dsdtech-official/can-adapters/docs/README.md

<!-- SPDX-FileCopyrightText: 2026 DongGuan DESHIDE TECHNOLOGY CO., LTD (DSD TECH) -->
<!-- SPDX-License-Identifier: CC-BY-SA-4.0 -->
# Shared documentation

Shared guides for adapters in this repository. Check each guide's model coverage.
Model-specific material lives in the model's own folder.

| File | Answers |
|---|---|
| [`software.md`](software.md) | Get diCAN for Windows or macOS; match your adapter and firmware to the available features |
| [`firmware-update-sh-c31a-sh-c31g.md`](firmware-update-sh-c31a-sh-c31g.md) | Illustrated Windows upgrade guide for SH-C31A / SH-C31G: BOOT switch, x64/ARM64 drivers, dfu-util and STM32CubeProgrammer pictures |
| `identify-firmware.md` | Which firmware is on my adapter, and how do I change it? |
| `termination.md` | When must the 120 Ω terminator be switched off? *(the #1 support question)* |
| `leds.md` | What the three lights mean, and why the green ones are dark |
| `other-firmware.md` | **ElmueSoft CANable 2.5** — optional third-party firmware for the SH-C31A and SH-C31G, and which of its two forms you want |
| `elmue-candlelight-2.5.md` | What changes on the bench with the gs_usb form of it |
| `elmue-slcan-2.5.md` | What changes on the bench with the serial-port form of it |

More is being written — measured bit rate and sample point tables, per-OS setup guides and
troubleshooting.
