dsdtech-official/can-adapters/SH-C31G/README.md

<!-- SPDX-FileCopyrightText: 2026 DongGuan DESHIDE TECHNOLOGY CO., LTD (DSD TECH) -->
<!-- SPDX-License-Identifier: CC-BY-SA-4.0 -->
# SH-C31G

**Galvanically isolated** USB to **CAN FD** adapter. The isolated sibling of the
[SH-C31A](../SH-C31A/) — same microcontroller, same firmware, with the CAN side cut loose
from the USB side. Part of the **CANable** family: lineage and attribution in
[`THIRD-PARTY-NOTICES.md`](../THIRD-PARTY-NOTICES.md).

> **Buy:** <https://www.deshide.com/product-details_SH-C31G.html> ·
> **Non-isolated version:** [SH-C31A](../SH-C31A/)

| | |
|---|---|
| MCU | **STM32G431** — 170 MHz Cortex-M4F, FDCAN. Both the **C8T6** (64 KB flash) and the **CBT6** (128 KB) are fitted in production; the firmware is the same either way |
| Transceiver | **TJA1051T/3** (NXP) |
| **Isolation** | ✅ **Digital isolator + isolated DC-DC.** Signal *and* power are isolated — the parts, and which one we actually fit, are in [`hardware/`](hardware/) |
| **CAN FD** | ✅ **Working out of the box, at data rates up to 5 Mbit/s** — same firmware and same interface as the SH-C31A, see [`firmware/`](firmware/) |
| Classic CAN | CAN 2.0A and 2.0B |
| Clock | No external crystal — the MCU runs from its internal oscillator |
| USB | USB 2.0 Full Speed, **Type-B receptacle** (cable not captive) |
| CAN | **4-pin 5.08 mm screw terminal** — CAN_L / CAN_H / GND / +5 V |
| Board | 53.5 × 36.0 mm |

> ⚠️ **One limit is your software, not this adapter.** Over SocketCAN every standard
> nominal rate works. `python-can`'s `gs_usb` backend can only open 500 kbit/s and
> 1 Mbit/s — a restriction inside that library, not a property of the board.
> [`firmware/`](firmware/) has the measurements.

## The isolated side powers itself

**You do not need an external supply.** The on-board DC-DC converter makes the isolated
5 V from USB, and the transceiver runs from it. Pin 4 of the terminal carries that isolated
5 V, so it can also feed a small load on the bus side — it is an output, not an input.

## Software

Use **[diCAN](../docs/software.md)** on Windows or macOS to view, send and record CAN
traffic with this adapter. CAN FD availability depends on the firmware installed;
the guide shows how to check it.

## Start here

1. **[Manual](manual/)** — wiring, LEDs, first connection
2. **Check the 120 Ω terminator.** Switch it **off** when the bus already has two, which a
   vehicle bus does → [`docs/termination.md`](../docs/termination.md)
3. **Check your firmware.** We recommend the shared **v1.5** build for SH-C31G owners;
   see the [firmware downloads](firmware/) and the illustrated
   [Windows firmware upgrade guide](../docs/firmware-update-sh-c31a-sh-c31g.md).
4. **The green LEDs stay dark until software opens the channel.** That is normal →
   [`docs/leds.md`](../docs/leds.md)
5. **[Examples](examples/)** — read the bus, send a frame, send an FD frame

## In this folder

| | |
|---|---|
| [`manual/`](manual/) | User manual |
| [`datasheet/`](datasheet/) | Electrical and mechanical specifications |
| [`hardware/`](hardware/) | Schematic and board files |
| [`firmware/`](firmware/) | What it runs, what that firmware can do, and how to change it |
| [`examples/`](examples/) | Working code |

Firmware images are attached to [Releases](../../../releases), not stored in this folder.

## Licence

Hardware design files: **CERN-OHL-S-2.0** · Documentation: **CC-BY-SA-4.0** ·
Example code: **BSD-3-Clause** · Firmware images: **MIT**. See [LICENSES/](../LICENSES/).

**No warranty.** Provided AS IS.
