dsdtech-official/can-adapters/SH-C30A/firmware/README.md

<!-- SPDX-FileCopyrightText: 2026 DongGuan DESHIDE TECHNOLOGY CO., LTD (DSD TECH) -->
<!-- SPDX-License-Identifier: CC-BY-SA-4.0 -->
# SH-C30A — Firmware

## What this board ships with

**candlelight.** The adapter presents itself as a raw USB device: the kernel `gs_usb`
driver on Linux, WinUSB on Windows.

**The SH-C30A has no CAN FD and cannot gain it by reflashing** — the STM32F072 has a
classic bxCAN peripheral, not FDCAN. It runs CAN 2.0A and 2.0B at up to 1 Mbit/s.

### Your adapter may be running an earlier build

**Units produced from September 2026 ship with v2.1**, the image on
[Releases](#download). Anything made before that carries the stock CANable build, and so
does older stock still moving through distribution. **Those units keep working and you can
stay on them** -- but `v2.1` does fix two behaviours worth having:

- **closing the channel purges the transmit queue**, so frames left over from one session no
  longer go out after the next open
- **both LEDs work**

**v2.1 runs the microcontroller from the 24 MHz crystal fitted on the board.** Every
SH-C30A has that crystal.

**To check which one you have**, look at the name the adapter reports over USB:

| | |
|---|---|
| Windows | Device Manager, under *Universal Serial Bus devices* |
| Linux | `lsusb` |

v2.1 reports itself as **`SH-C30x`**, made by **`DSD TECH`**. Anything else is an earlier
build. To move to v2.1, take it from **[Download](#download)** below and flash it. A USB
cable is all you need.

## Which firmware do I have?

Two personalities exist for this class of adapter and they look completely different to the
host. Ten seconds to tell them apart →
[`docs/identify-firmware.md`](../../docs/identify-firmware.md)

| | **candlelight** | **slcan** |
|---|---|---|
| Appears as | a raw USB device | a serial port |
| Windows | *Universal Serial Bus devices*, WinUSB | `COM<n>` under *Ports* |
| Linux | kernel `gs_usb` → a **SocketCAN** interface | `/dev/ttyACM<n>` |

## Download

**[SH-C30A firmware v2.1](https://github.com/dsdtech-official/can-adapters/releases/tag/SH-C30A/fw-v2.1)** — the current build, and what units produced from September 2026
ship with.

| File | |
|---|---|
| [`SH-C30x_v2.1.dfu`](https://github.com/dsdtech-official/can-adapters/releases/download/SH-C30A/fw-v2.1/SH-C30x_v2.1.dfu) | **Start here.** DfuSe format, for `dfu-util` or ST tools |
| [`SH-C30x_v2.1.bin`](https://github.com/dsdtech-official/can-adapters/releases/download/SH-C30A/fw-v2.1/SH-C30x_v2.1.bin) | Raw image, flashed at `0x08000000` |
| [`SH-C30x_v2.1.hex`](https://github.com/dsdtech-official/can-adapters/releases/download/SH-C30A/fw-v2.1/SH-C30x_v2.1.hex) | Intel HEX |
| [`SHA256SUMS.txt`](https://github.com/dsdtech-official/can-adapters/releases/download/SH-C30A/fw-v2.1/SHA256SUMS.txt) | Checksums for the three above |
| [`THIRD-PARTY-NOTICES.md`](https://github.com/dsdtech-official/can-adapters/releases/download/SH-C30A/fw-v2.1/THIRD-PARTY-NOTICES.md) | The licence notice. **Carry it with the images if you mirror them** |

One build serves **SH-C30A, SH-C30G and SH-C30L**.

Check what you downloaded before flashing it:

```bash
sha256sum -c SHA256SUMS.txt
```

Images are not kept in this folder. Binaries cannot be removed from git history
afterwards, and a release ties an image to a version you can quote in a support request.

## Flashing

Both personalities are flashed over USB DFU, to the STM32 system bootloader
(`0483:DF11`). A USB cable is all you need.

> ⚠️ **Reflashing is not required for normal use.** An adapter on an earlier build keeps
> working. Reflash if you want the current build, or if you specifically need the other
> personality.

## Licence and attribution

The firmware images we publish are built from **candleLight_fw** by **Hubert Denkmair**,
released under the **MIT** licence.

> Copyright (c) 2016 Hubert Denkmair — [`LICENSES/MIT.txt`](../../LICENSES/MIT.txt)

MIT requires the copyright and permission notice to be included **in binary distributions
too**, so [`THIRD-PARTY-NOTICES.md`](../../THIRD-PARTY-NOTICES.md) ships with every firmware
release. It also records two components inside candleLight_fw that carry their own terms —
the **STM32 HAL** (BSD-style) and the **STM32 USB library**
(**ST Ultimate Liberty License SLA0044**, not an OSI-approved licence).

**If you mirror our firmware images anywhere, carry that file with them.**
