dsdtech-official/can-adapters/docs/other-firmware.md

<!-- SPDX-FileCopyrightText: 2026 DongGuan DESHIDE TECHNOLOGY CO., LTD (DSD TECH) -->
<!-- SPDX-License-Identifier: CC-BY-SA-4.0 -->
# Other firmware — ElmueSoft CANable 2.5

The **SH-C31A** and **SH-C31G** ship with our own gs_usb build. They will also run
**ElmueSoft's CANable 2.5 firmware**, which is a separate project by a different author,
and we publish it here so you can choose.

> ### With thanks to Elmue
>
> **The DSD TECH team is very grateful to Elmue for this work.** CANable 2.5 is his own
> project, written and maintained by him, and he made it work across a range of boards from
> different manufacturers — including ours. The `Multiboard` builds on this page exist
> because he took the trouble to support hardware that has no crystal fitted, which is what
> our SH-C31A and SH-C31G are.
>
> His work is his own. Nothing on this page should be read as him endorsing us or our
> products.

> ## 🔴 What you download here is a snapshot, not the latest
>
> **These files are one specific build, commit
> [`eb1c7e35`](https://github.com/Elmue/CANable-2.5-firmware-Slcan-and-Candlelight/commit/eb1c7e3589b6135469dd0745c3a81911b88513c6)
> of 2026-09-15, mirrored here on 2026-09-16.** Elmue improves this firmware on his own
> schedule, and when he does, **what is on this page is out of date until we catch up.**
>
> **The current version is always on his own pages, never here:**
> <https://netcult.ch/elmue/CANable%20Firmware%20Update> ·
> <https://github.com/Elmue/CANable-2.5-firmware-Slcan-and-Candlelight>
>
> We mirror a pinned build for two reasons only: so the checksums below have something to
> check against, and so the file stays reachable. **If you want the newest, go to his
> repository.**

## First: which firmwares exist at all

There are four, and only four:

| | Host interface | Whose it is |
|---|---|---|
| **legacy candleLight** (`gs_usb`) | raw USB | the original open-source project. **Our own build is in this class** |
| **legacy slcan** | serial port | the original open-source project |
| **Candlelight 2.5** | raw USB | ElmueSoft — a rework of the first one. **On this page** |
| **Slcan 2.5** | serial port | ElmueSoft — a rework of the second one. **On this page** |

The division that matters is **raw USB versus serial port**, because it decides which
software can talk to the adapter at all. The `2.5` pair are Elmue's rewrites: the same two
host interfaces, but with added features, error reporting the legacy builds never had, and
different bit-timing defaults.

## Which of the two do I want?

Both are built from the same source at the same version. They differ in **how the adapter
talks to your computer**, and that decides which software can use it.

| | **Candlelight 2.5** | **Slcan 2.5** |
|---|---|---|
| Host interface | Raw USB (`gs_usb` / WinUSB) | **CDC virtual serial port** |
| Windows driver | **None to install — WinUSB binds by itself** | **None to install — it appears as a COM port** |
| Linux | SocketCAN via the kernel `gs_usb` driver | SocketCAN via `slcand`, or any serial tool |
| CAN FD | ✅ | ✅ |
| Closest to what we ship | ✅ same class of interface | ❌ different class entirely |
| Details | [`elmue-candlelight-2.5.md`](elmue-candlelight-2.5.md) | [`elmue-slcan-2.5.md`](elmue-slcan-2.5.md) |

> ℹ️ **Neither of these needs a driver installed by hand on Windows.** Candlelight 2.5
> carries the descriptors that make Windows bind WinUSB on its own; Slcan 2.5 shows up as a
> COM port. **The manual-driver step you may have read about belongs to the *legacy*
> candleLight firmware, not to these.**
>
> ⛔ **Do not run Zadig against either of them.** It installs the driver under a randomly
> generated device GUID, and software looking for the standard one will then not find the
> adapter at all. Elmue's own firmware updater can repair a registry Zadig has done this to.

**If you are happy with the firmware the adapter came with, you do not need either of
these.** Our own build is what we test, what we support, and what every measurement on the
model pages was taken on.

**Reasons people do want one of them:**

- **Slcan 2.5** puts the adapter on a plain COM port. If your software wants a serial
  port, or you would rather not deal with WinUSB at all, this is the one.
- **Candlelight 2.5** adds features our build does not have — `GET_STATE`, bus load
  reporting, filter and pin control, flash read/write — through Elmue's own extensions to
  the protocol.

**The author's own case for updating**, which we think is fair to pass on: 2.5 adds features
the legacy firmware does not have, and — the one we would single out — **it reports error
states that the legacy firmware simply did not surface at all**. If you have been chasing a
bus fault you could not see, that on its own may be worth the update.

## Three things to know before you flash

Each of these looks like a fault and is not. **Full detail is on the two pages linked in the
table above** — this is the short form.

| | |
|---|---|
| **Candlelight 2.5 reports the same USB `VID:PID` as our own build** | Both are `1D50:606F`. Any script or udev rule keyed on that alone matches both. Tell them apart by the **product string** — `Candlelight 2.5 - …` here, `SH-C31x` on ours. ⛔ Not by `bcdDevice`: his carries a build version and moves every release |
| **The CAN clock is 160 MHz; ours is 170 MHz** | Software that asks the device for its clock is fine. Software that assumes a fixed clock programs the wrong timings and **goes bus-off immediately** — it does not degrade into "a slightly different rate" |
| **On Slcan 2.5, `S7` is 800 kbit/s** | `python-can`'s slcan interface assumes 750 k, so it will run the bus at 800 k while believing it set 750 k. There is no standard value for `S7`; the two conventions both exist |

## Software: the author's own application

**If you flash this firmware, [HUD ECU Hacker](https://netcult.ch/elmue/HUD%20ECU%20Hacker/)
is the application it was written alongside — we recommend it.** Elmue wrote CANable 2.5
while adding CANable support to that program, and his documentation says it supports the new
firmware's features in full.

It can also **install this firmware for you**: it carries a built-in CANable firmware
updater, and using that is what he recommends over flashing by hand.

| | |
|---|---|
| What it is | ECU diagnostics and tuning, with a built-in CAN bus debugger, logger and terminal |
| Protocols | CAN Raw, ISO 15765, **J1939** (8 500 parameters), **NMEA 2000** (3 000 parameters), K-Line (ISO 9141, ISO 14230, KW1281, Honda) |
| Platform | **Windows only** — 7, 8, 10 and 11. Not Linux |
| Price | **Charityware** — he asks for a donation to a non-profit of your choice, not to himself |
| Source | Closed |
| Where | <https://netcult.ch/elmue/HUD%20ECU%20Hacker/> |

**We link rather than bundle it, and the capabilities listed above are his description
rather than our measurements.** Questions about it go to him, the same as for the firmware.

> **On Linux you need none of this.** The Candlelight build comes up as a SocketCAN
> interface through the kernel `gs_usb` driver, and the Slcan build through `slcand` — then
> `can-utils`, `python-can` or anything else that speaks SocketCAN.
>
> ⚠️ **What that route does not give you are Elmue's 2.5 extensions.** `gs_usb` speaks the
> original protocol, so `GET_STATE`, bus load, filters, pin control and flash access are not
> reachable through SocketCAN — those need his own host code. **Ordinary CAN and CAN FD
> traffic work normally.**

## Download

Both files are attached to a single release here, and both are **byte-for-byte the files
Elmue publishes**, taken from a pinned commit:

**[ElmueSoft CANable 2.5](https://github.com/dsdtech-official/can-adapters/releases/tag/SH-C31A/elmue-2.5)**

| File | For | SHA-256 |
|---|---|---|
| `STM32G431-Candlelight2.5-Multiboard.dfu` | gs_usb / WinUSB | `79d438f5…870480` |
| `STM32G431-Slcan2.5-Multiboard.dfu` | CDC serial port | `8d958470…65555a` |
| `SHA256SUMS.txt` | checksums for both | — |
| `THIRD-PARTY-NOTICES.md` | **the MIT notice. Carry it if you mirror these** | — |

> ℹ️ **What these checksums are for — and what they are not for.** A `.dfu` file already
> carries its own CRC32, and both `dfu-util` and the firmware updater in HUD ECU Hacker
> refuse to flash a file whose CRC does not match. **A half-finished download cannot reach
> the board**, so you do not need SHA-256 to protect yourself from that.
>
> They are here for the other reason: **this is a mirror of someone else's binary, and the
> hashes are how you confirm our copy is byte-for-byte the file Elmue published** rather
> than something we changed. Check them against his repository if you want to verify that
> for yourself instead of taking our word for it.

```bash
sha256sum -c SHA256SUMS.txt
```

### Where these came from, exactly

| | |
|---|---|
| Upstream | <https://github.com/Elmue/CANable-2.5-firmware-Slcan-and-Candlelight> |
| Pinned commit | [`eb1c7e35`](https://github.com/Elmue/CANable-2.5-firmware-Slcan-and-Candlelight/commit/eb1c7e3589b6135469dd0745c3a81911b88513c6) · 2026-09-15 |
| Author's page | <https://netcult.ch/elmue/CANable%20Firmware%20Update> |

> ℹ️ **We renamed the two files.** Upstream calls them
> `STM32G431 - Candlelight2.5 - Multiboard.dfu` and `STM32G431 - Slcan2.5 - Multiboard.dfu`,
> with spaces. GitHub replaces spaces in release assets with periods, which would break
> `sha256sum -c`, so ours use hyphens instead. **The contents are untouched** — the
> checksums above are of the upstream files exactly as published.

**We pin a commit rather than linking a branch,** because a branch moves and what we
publish is the build we actually put on a board. We verified that the files in the release
above are identical to that commit — same SHA-256, same byte count.

> ⚠️ **Upstream ships 18 different `.dfu` files.** They are for different boards and
> different clock configurations. **Take exactly the two named above** — the `Multiboard`
> ones. Flashing a variant built for a 25 MHz crystal onto a board that has none will not
> work, and the failure is not obvious.

> ⚠️ **Newer versions may exist upstream, and sooner or later one will.** We pin a build
> because that is the one we put on a board — see the snapshot notice at the top of this
> page. **His repository has the current one before we do.**

### Updated from a previous snapshot?

Until 2026-09-17 this page carried commit `e862f6a6` of 2026-08-27. **What changed between
the two is his to describe, not ours** — we did not make those changes, and guessing at them
would be worse than not saying. **His release notes and his own pages are the authority:**

* <https://netcult.ch/elmue/CANable%20Firmware%20Update>
* <https://github.com/Elmue/CANable-2.5-firmware-Slcan-and-Candlelight>

One practical note, because it concerns the file **we** handed out rather than anything we
can tell you about his work: if you are staying on the copy we published before 2026-09-17
and you drive the adapter directly over `gs_usb`, **keep your `echo_id` inside `1`–`255`.**
We do not see that behaviour on the current file, and the Linux kernel's `gs_usb` driver is
not affected either way.

> ⚠️ **Do not identify this firmware by `bcdDevice`.** It carries his build version, so it
> moves every time he releases. **Match on the product string** — `Candlelight 2.5 - …` or
> `Slcan 2.5 - …`.

## Flashing

These files are flashed through the STM32 system bootloader (`0483:DF11`), but **how you
enter DFU depends on the firmware currently on your adapter**. On SH-C31A or SH-C31G
running our v1.5, first unlock BOOT0 as described in the
[SH-C31A flashing steps](../SH-C31A/firmware/#flashing). On an as-shipped SH-C31B,
BOOT0 is disabled, so the switch alone will not enter DFU. Check its firmware and the
author's update instructions before starting. Do not erase the running firmware until
you have confirmed the adapter is in ROM DFU mode.

### Going back

Our own build is on the model's firmware page
([SH-C31A](../SH-C31A/firmware/README.md#download) ·
[SH-C31G](../SH-C31G/firmware/README.md)). The bootloader lives in ROM, but a disabled
BOOT0 pin means the switch alone cannot reach it. Follow your model's unlock steps
before changing firmware, and verify the new firmware's BOOT0 behavior before flashing.

## What we support, and what we do not

**We did not write this firmware, we do not maintain it, and we cannot rebuild it** — what
we publish is the author's own precompiled file, not something we compiled ourselves.

| | |
|---|---|
| **Hardware faults** | ✅ Ours. Warranty is unaffected by which firmware you run |
| **Getting back to our firmware** | ✅ Ours — ask us |
| **Bugs in CANable 2.5** | ⛔ Report upstream: <https://github.com/Elmue/CANable-2.5-firmware-Slcan-and-Candlelight/issues> |
| **Feature requests for CANable 2.5** | ⛔ Upstream. It is his project |

**Please do not send Elmue support requests about our hardware, and please do not send us
feature requests about his firmware.** Each of us can only fix our own half.

## Licence

The firmware source carries **the MIT licence**:

```
The MIT License
Copyright (c) 2025 ElmueSoft / Nakanishi Kiyomaro / Normadotcom
https://netcult.ch/elmue/CANable Firmware Update
```

MIT permits redistribution in source or binary form **provided that notice travels with
it**, which is why [`THIRD-PARTY-NOTICES.md`](../THIRD-PARTY-NOTICES.md) is attached to the
release. **If you mirror these images anywhere, carry that file with them.**

> Note that the copyright is held by **three** parties, not one. The sample applications in
> the same upstream repository are under a **different** licence (BSD-3-Clause) — if you use
> those as well, read their own `License.txt`.
