dsdtech-official/can-adapters/SH-C30G/examples/linux-socketcan.md

<!-- SPDX-FileCopyrightText: 2026 DongGuan DESHIDE TECHNOLOGY CO., LTD (DSD TECH) -->
<!-- SPDX-License-Identifier: CC-BY-SA-4.0 -->
# SH-C30G on Linux — SocketCAN

Nothing to install: the kernel `gs_usb` driver claims the adapter and presents it as a
standard CAN network interface.

> ## Before anything else: **which firmware is on this adapter?**
>
> SH-C30G has shipped with **two different firmwares**, both of which are in the field
> today, and **you cannot tell them apart by looking at the board**. They behave
> differently in one way that will cost you a debugging session. Identify first.

## Check the kernel picked it up

```bash
ip link show | grep can
```

A `can0` interface means the kernel driver has it. If you get a `/dev/ttyACM<n>` instead,
the adapter is running a serial-port firmware rather than a CAN one →
[`docs/identify-firmware.md`](../../docs/identify-firmware.md)

## Identify the firmware

```bash
cat /sys/class/net/can0/device/../bcdDevice \
    /sys/class/net/can0/device/../product \
    /sys/class/net/can0/device/../manufacturer
```

That prints, in order, the device release number, the product string and the vendor
string — the three fields that name the firmware. To list every candleLight-family
adapter on the machine instead:

```bash
for d in /sys/bus/usb/devices/*; do
  [ -e "$d/idVendor" ] || continue
  [ "$(cat "$d/idVendor")" = "1d50" ] && [ "$(cat "$d/idProduct")" = "606f" ] || continue
  printf '%-10s bcdDevice=%-6s product=%-32s manufacturer=%s\n' \
    "${d##*/}" "$(cat "$d/bcdDevice")" "$(cat "$d/product")" "$(cat "$d/manufacturer")"
done
```

| `bcdDevice` | `product` | This is |
|---|---|---|
| `0100` | `SH-C30x` *(or `sh-C30x`)* | the firmware a **new** adapter ships with |
| `0000` | `candleLight USB to CAN adapter` | an adapter made **before September 2026** |
| `0000` · `0200` | `canable2 gs_usb` · `SH-C31x` | ⚠️ **not this product** — that is an SH-C31A |

📖 **The full table, what differs between the two, and the rules for reading any of
it are in [`README.md`](README.md)** — one place, so there is only one to keep right.

> 🔴 **The one difference that bites on Linux.** On the older firmware,
> `ip link set can0 down` with frames still queued does **not** discard them; they go out
> after you bring the interface back up, into whatever bus you are attached to by then.
> **Drain before you take the interface down.** The current firmware purges both queues
> on close. ⛔ **Do not carry a workaround for one over to the other.**

## Bring the bus up

```bash
sudo ip link set can0 up type can bitrate 500000
```

⚠️ **Every node on a bus must use the same bit rate**, and the bus must be terminated at
both ends and nowhere else → [`docs/termination.md`](../../docs/termination.md)

### 🔴 Hardware limit: **10 kbit/s cannot transmit on this board**

This is a property of the **board**, not of either firmware — it is there on both firmwares
alike, and reflashing will not change it.

The transceiver's dominant-state timeout is **400–500 µs**, and five consecutive dominant
bits at 10 kbit/s take **500 µs**. A frame containing five consecutive dominant bits never
gets out. Reproduced across three firmwares, two boards and two independent
implementations.

> **On provenance:** those runs were on the [SH-C30A](../../SH-C30A/examples/) — same
> image, equivalent transceiver from a different vendor. **We have not measured it on the
> SH-C30G itself.** The table below is what we would assume here; confirm it on your own
> bench if 10–20 kbit/s matters to you.

> ⚠️ **SocketCAN will let you do it anyway.** `ip link set can0 up type can bitrate 10000`
> succeeds, the interface comes up, and then frames silently fail to leave. There is no
> error to tell you why. (On Windows, python-can happens to refuse 10 kbit/s for an
> unrelated reason, which hides the problem rather than reporting it.)

| Rate | |
|---|---|
| 5 kbit/s | ⛔ do not use — worse than 10 k by the same mechanism |
| **10 kbit/s** | 🔴 **opens but cannot transmit** |
| 20 kbit/s | ⚠️ works, but only **17 %** margin against the transceiver's timeout |
| **100 kbit/s – 1 Mbit/s** | ✅ the usable range |

## Watch traffic

```bash
candump can0
```

## Send a frame

```bash
cansend can0 123#DEADBEEF
```

> ⚠️ **`cansend` returning does not mean the frame reached the bus.** With no other node
> to acknowledge, the controller retransmits indefinitely, the transmit error counter
> climbs to 128 and the controller goes error-passive — measured on this hardware, TEC
> stops at 128 and it never reaches bus-off. Nothing is printed. To see it:
>
> ```bash
> ip -details -statistics link show can0 | grep -A2 -E 'state|bus_error'
> candump can0,#FFFFFFFF          # error frames as well as data frames
> ```

## Listen without transmitting

`listen-only` asks the CAN controller for silent mode: it receives, and it does not drive
the bus — no frames of its own, and no acknowledgements.

```bash
sudo ip link set can0 down
sudo ip link set can0 up type can bitrate 500000 listen-only on
```

✅ **Measured on both SH-C30G firmwares** (2026-09-15): with the adapter in `listen-only`,
a witness node on the same bus recorded **zero** frames from it. Both firmwares honour
it.

> ⚠️ **Still prove it on a bench before you trust it on a vehicle** — and here is a
> concrete reason, not a formality: **the original firmware of our other model, the
> SH-C31A, reports `listen-only` and does not honour it.** It transmits and acknowledges
> anyway. If your fleet mixes adapters, verify each one on a bus you own.
>
> (SH-C30G is not affected. This is exactly why the identify step at the top matters.)

## Take the bus down

```bash
sudo ip link set can0 down
```

🔴 **On the older firmware, drain first** — see the note under [Identify the firmware](#identify-the-firmware).

---

`candump` and `cansend` come from **can-utils** (`sudo apt install can-utils`).
