dsdtech-official/can-adapters/docs/compliance/README.md

<!-- SPDX-FileCopyrightText: 2026 DongGuan DESHIDE TECHNOLOGY CO., LTD (DSD TECH) -->
<!-- SPDX-License-Identifier: CC-BY-SA-4.0 -->
# Compliance documents

Original laboratory attestations for DSD TECH USB-to-CAN adapters are provided
below. Each PDF lists the same five models; the files are shared rather than
copied into each model folder.

## Documents

| Document | Registration number | Issue date | Original PDF |
|---|---|---|---|
| CE (EMC) attestation of conformity | AGC09162260901E2 | 2026-09-28 | [View / download PDF](ce-emc-AGC09162260901E2.pdf) |
| RoHS attestation of conformity | AGC09162260901-C001 | 2026-09-15 | [View / download PDF](rohs-AGC09162260901-C001.pdf) |

Applicant / manufacturer: **DongGuan DESHIDE TECHNOLOGY CO.,LTD**.
Brand: **DSD TECH**.

## Models listed in both documents

| Model | CE (EMC) PDF | RoHS PDF |
|---|---|---|
| [SH-C30A](../../SH-C30A/) | Listed | Listed |
| [SH-C30L](../../SH-C30L/) | Listed | Listed |
| [SH-C31A](../../SH-C31A/) | Listed | Listed |
| [SH-C31B](../../SH-C31B/) | Listed | Listed |
| SH-C32A | Listed | Listed |

SH-C32A is listed in these attestations but does not yet have a model folder
in this repository. This index does not define its product specifications.
Models not listed in these PDFs are outside the stated scope of these documents.
The documents concern the specified DSD TECH products; building a board from
open hardware files does not transfer their coverage to that board.

## Scope and supporting reports

- The CE (EMC) attestation concerns Directive 2014/30/EU and lists
  EN 55032:2015+A11:2020+A1:2020 and EN 55035:2017+A11:2020.
  It references test report **AGC09162260901EE01**.
- The RoHS attestation concerns Directive 2011/65/EU and amendment
  (EU) 2015/863. It lists IEC 62321 test standards and references test report
  **AGC09162260901-001**.

These PDFs are laboratory attestations, not the full test reports or a
manufacturer-signed EU Declaration of Conformity. The referenced full reports
are not included here. The PDFs state that they should be used in conjunction
with the full reports and do not imply assessment of the whole production.

## Original files and terms

The PDFs are distributed complete and unchanged. Their own printed conditions
remain applicable, including restrictions on partial reproduction; do not
extract signatures, stamps or selected pages as separate proof documents.

These laboratory PDFs are **not relicensed under this repository's CC BY-SA,
hardware or software licences**. The adjacent `.license` files identify the
[original document terms](../../LICENSES/LicenseRef-Original-Compliance-Terms.txt),
without asserting a copyright owner that the PDFs do not identify. That
identifier records the existing terms; it does not grant a new open licence.
The explanatory text in this index follows the repository's documentation
licence. See [Licensing](../../LICENSE.md).

[All CAN adapters](../../README.md)
