dsdtech-official/can-adapters/SH-C31B/datasheet/README.md

<!-- SPDX-FileCopyrightText: 2026 DongGuan DESHIDE TECHNOLOGY CO., LTD (DSD TECH) -->
<!-- SPDX-License-Identifier: CC-BY-SA-4.0 -->
# SH-C31B — Datasheet

Electrical and mechanical specifications for the SH-C31B.

**The board is an [SH-C31A](../../SH-C31A/)** — the electrical and mechanical figures are
the same, and only the firmware fitted at the factory differs.

_Being migrated here from the product page. Until it lands:_ <https://www.deshide.com>
