dsdtech-official/can-adapters/SH-C31B/manual/README.md

<!-- SPDX-FileCopyrightText: 2026 DongGuan DESHIDE TECHNOLOGY CO., LTD (DSD TECH) -->
<!-- SPDX-License-Identifier: CC-BY-SA-4.0 -->
# SH-C31B — Manual

The user manual for the SH-C31B.

**Wiring, LEDs and termination are the same as the [SH-C31A](../../SH-C31A/).** What differs
is the first connection: this adapter appears as a **serial port**, not as a gs_usb device →
[`docs/elmue-slcan-2.5.md`](../../docs/elmue-slcan-2.5.md)

_Being migrated here from the product page. Until it lands:_ <https://www.deshide.com>
