dsdtech-official/can-adapters/SH-C30A/manual/README.md

<!-- SPDX-FileCopyrightText: 2026 DongGuan DESHIDE TECHNOLOGY CO., LTD (DSD TECH) -->
<!-- SPDX-License-Identifier: CC-BY-SA-4.0 -->
# SH-C30A — Manual

The user manual for the SH-C30A.

_Being migrated here from the product page. Until it lands:_ <https://www.deshide.com>
