dsdtech-official/can-adapters/SH-C30L/hardware/SH-C30L-V1.0.pdf

1

2

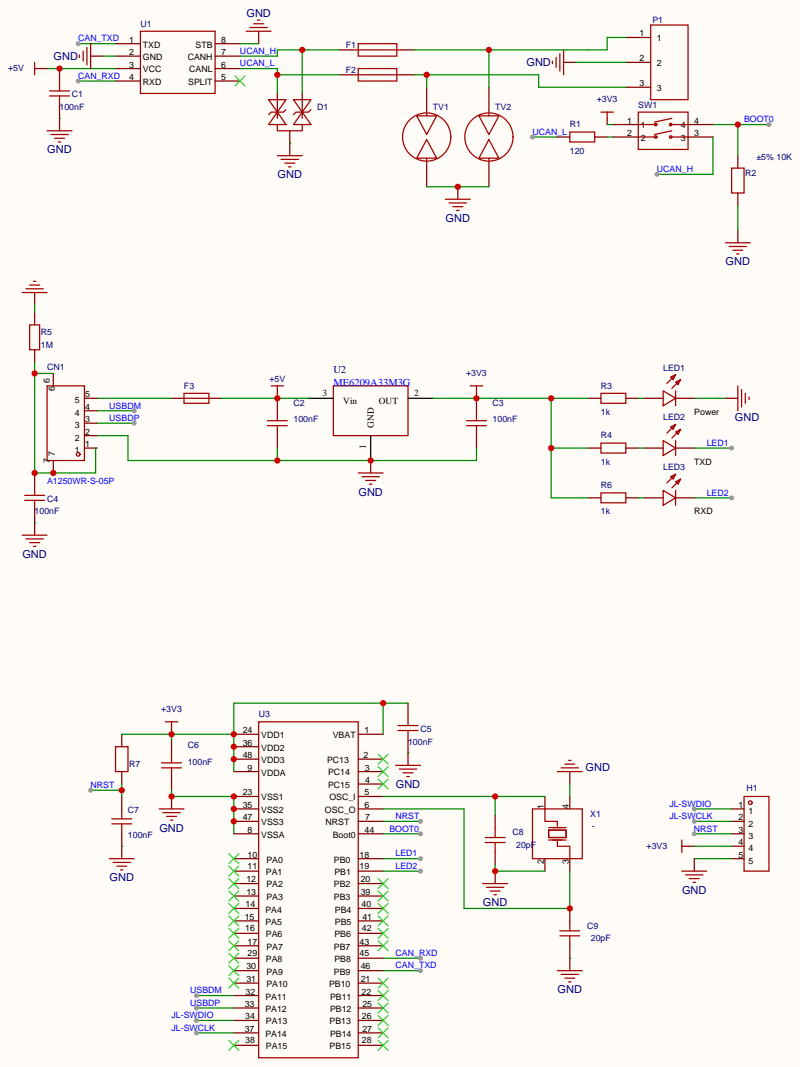
[picture p8: page 1]
