dsdtech-official/can-adapters/SH-C30G/hardware/SH-C30G-V1.5.pdf

1

2

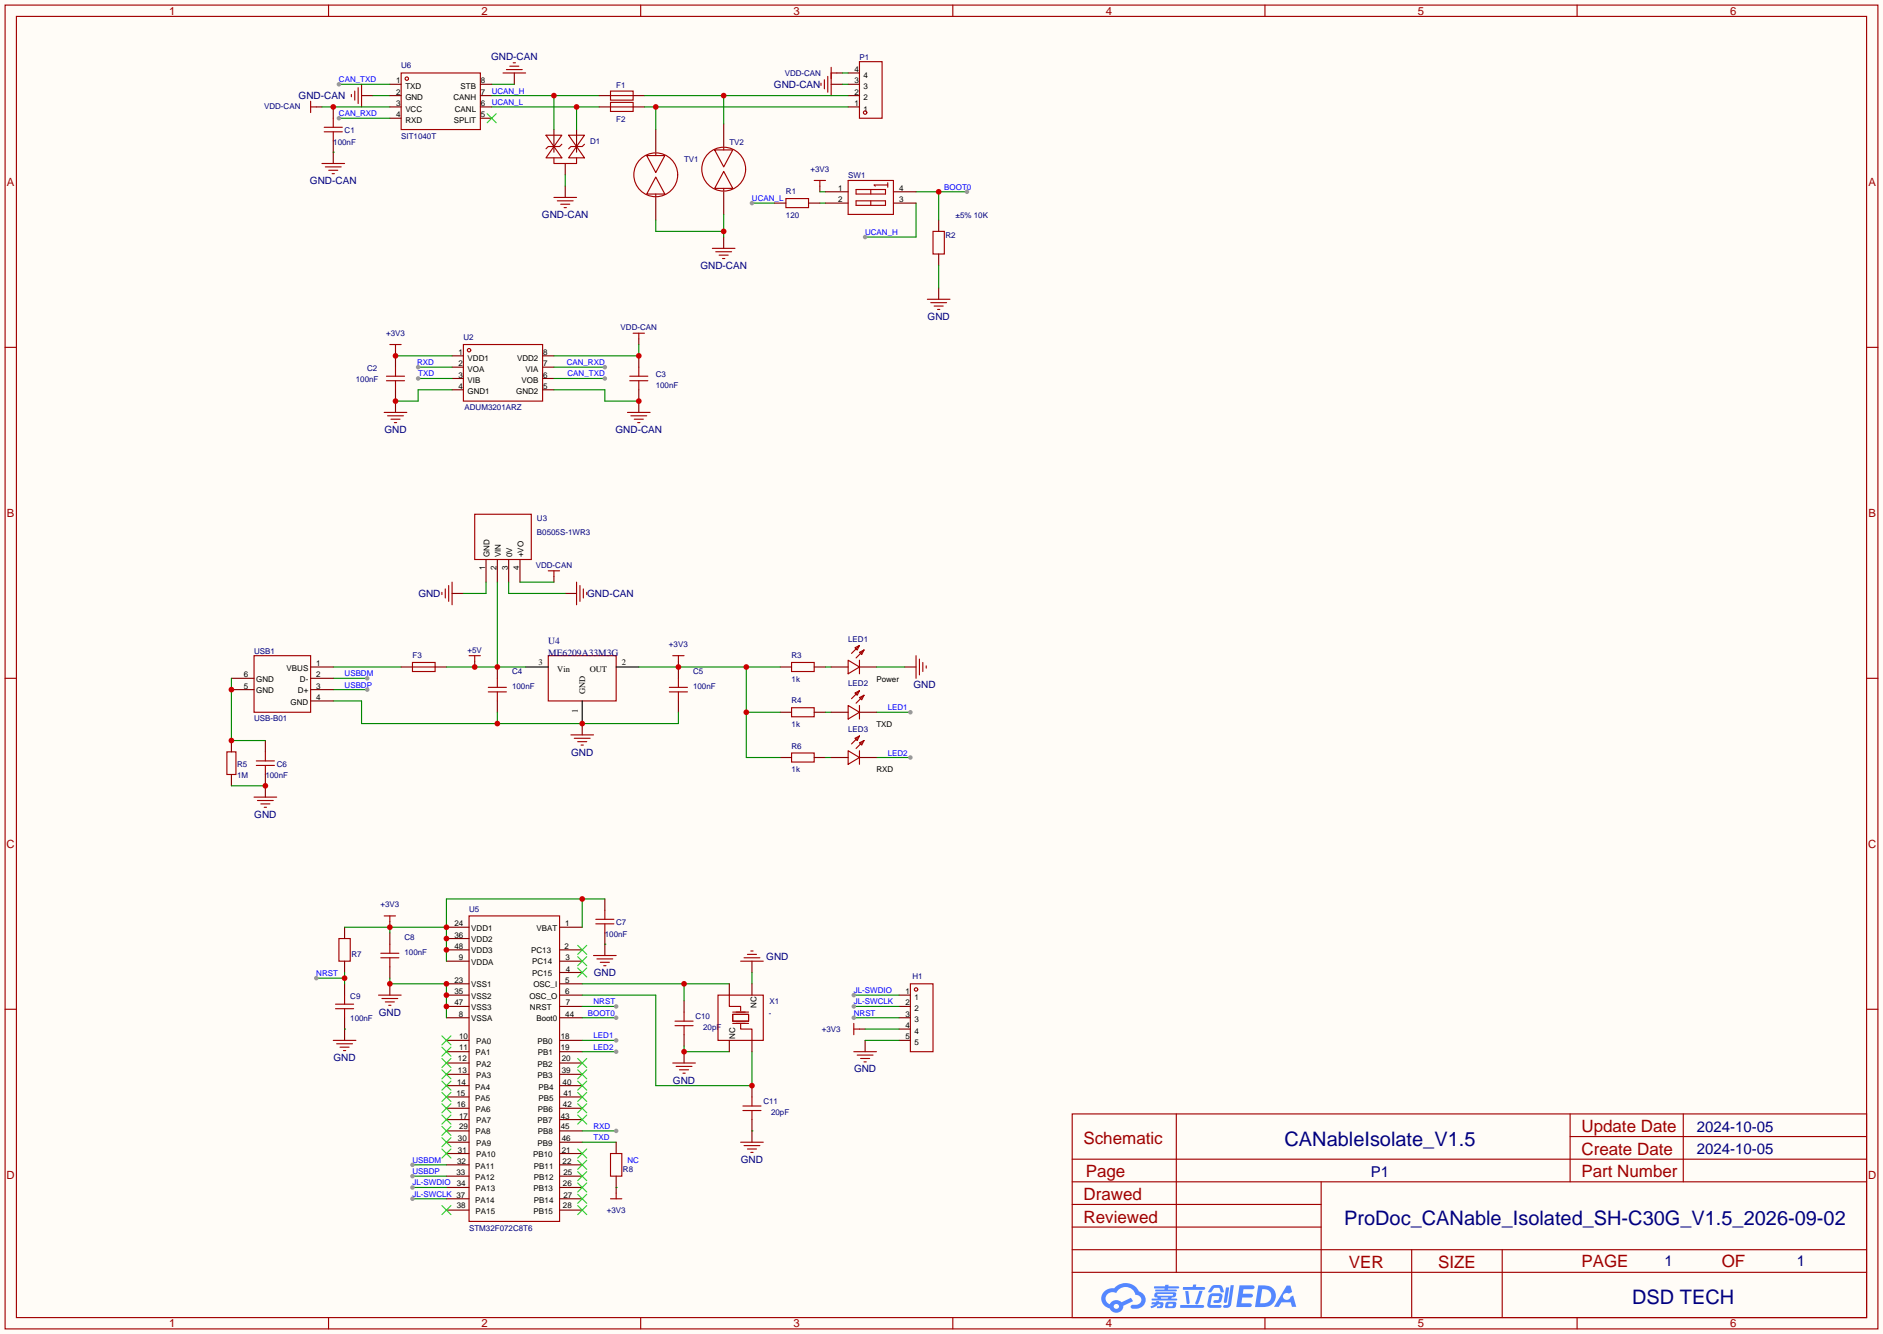
[picture p9: page 1]
