dsdtech-official/can-adapters/SH-C31G/hardware/SH-C31G-V1.0.pdf

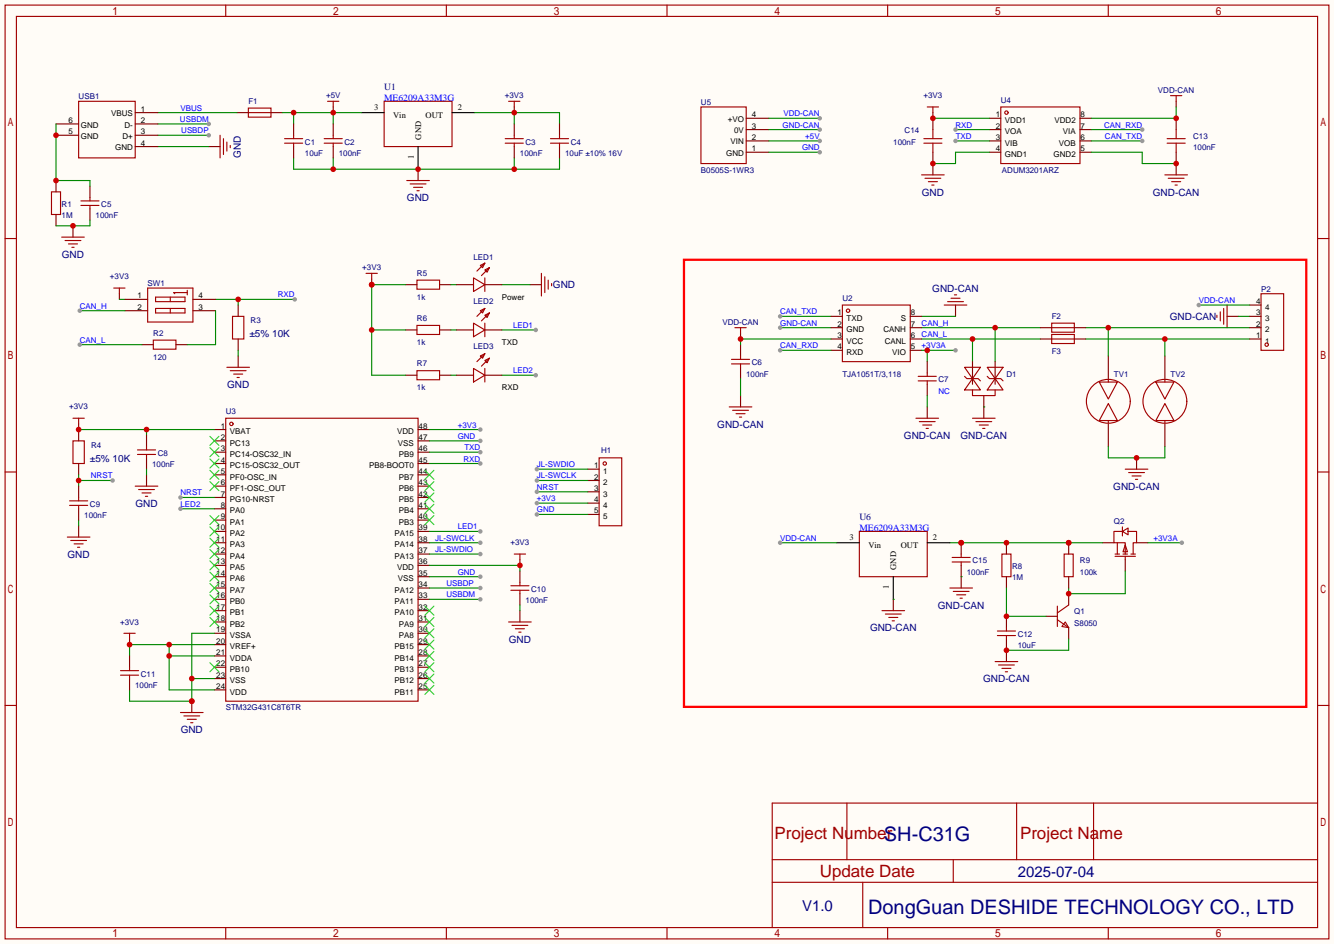
[picture p10: page 1]

Update Date
DongGuan DESHIDE TECHNOLOGY CO., LTD
