dsdtech-official/can-adapters/SH-C31A/hardware/SH-C31A-V1.1.pdf

1

2

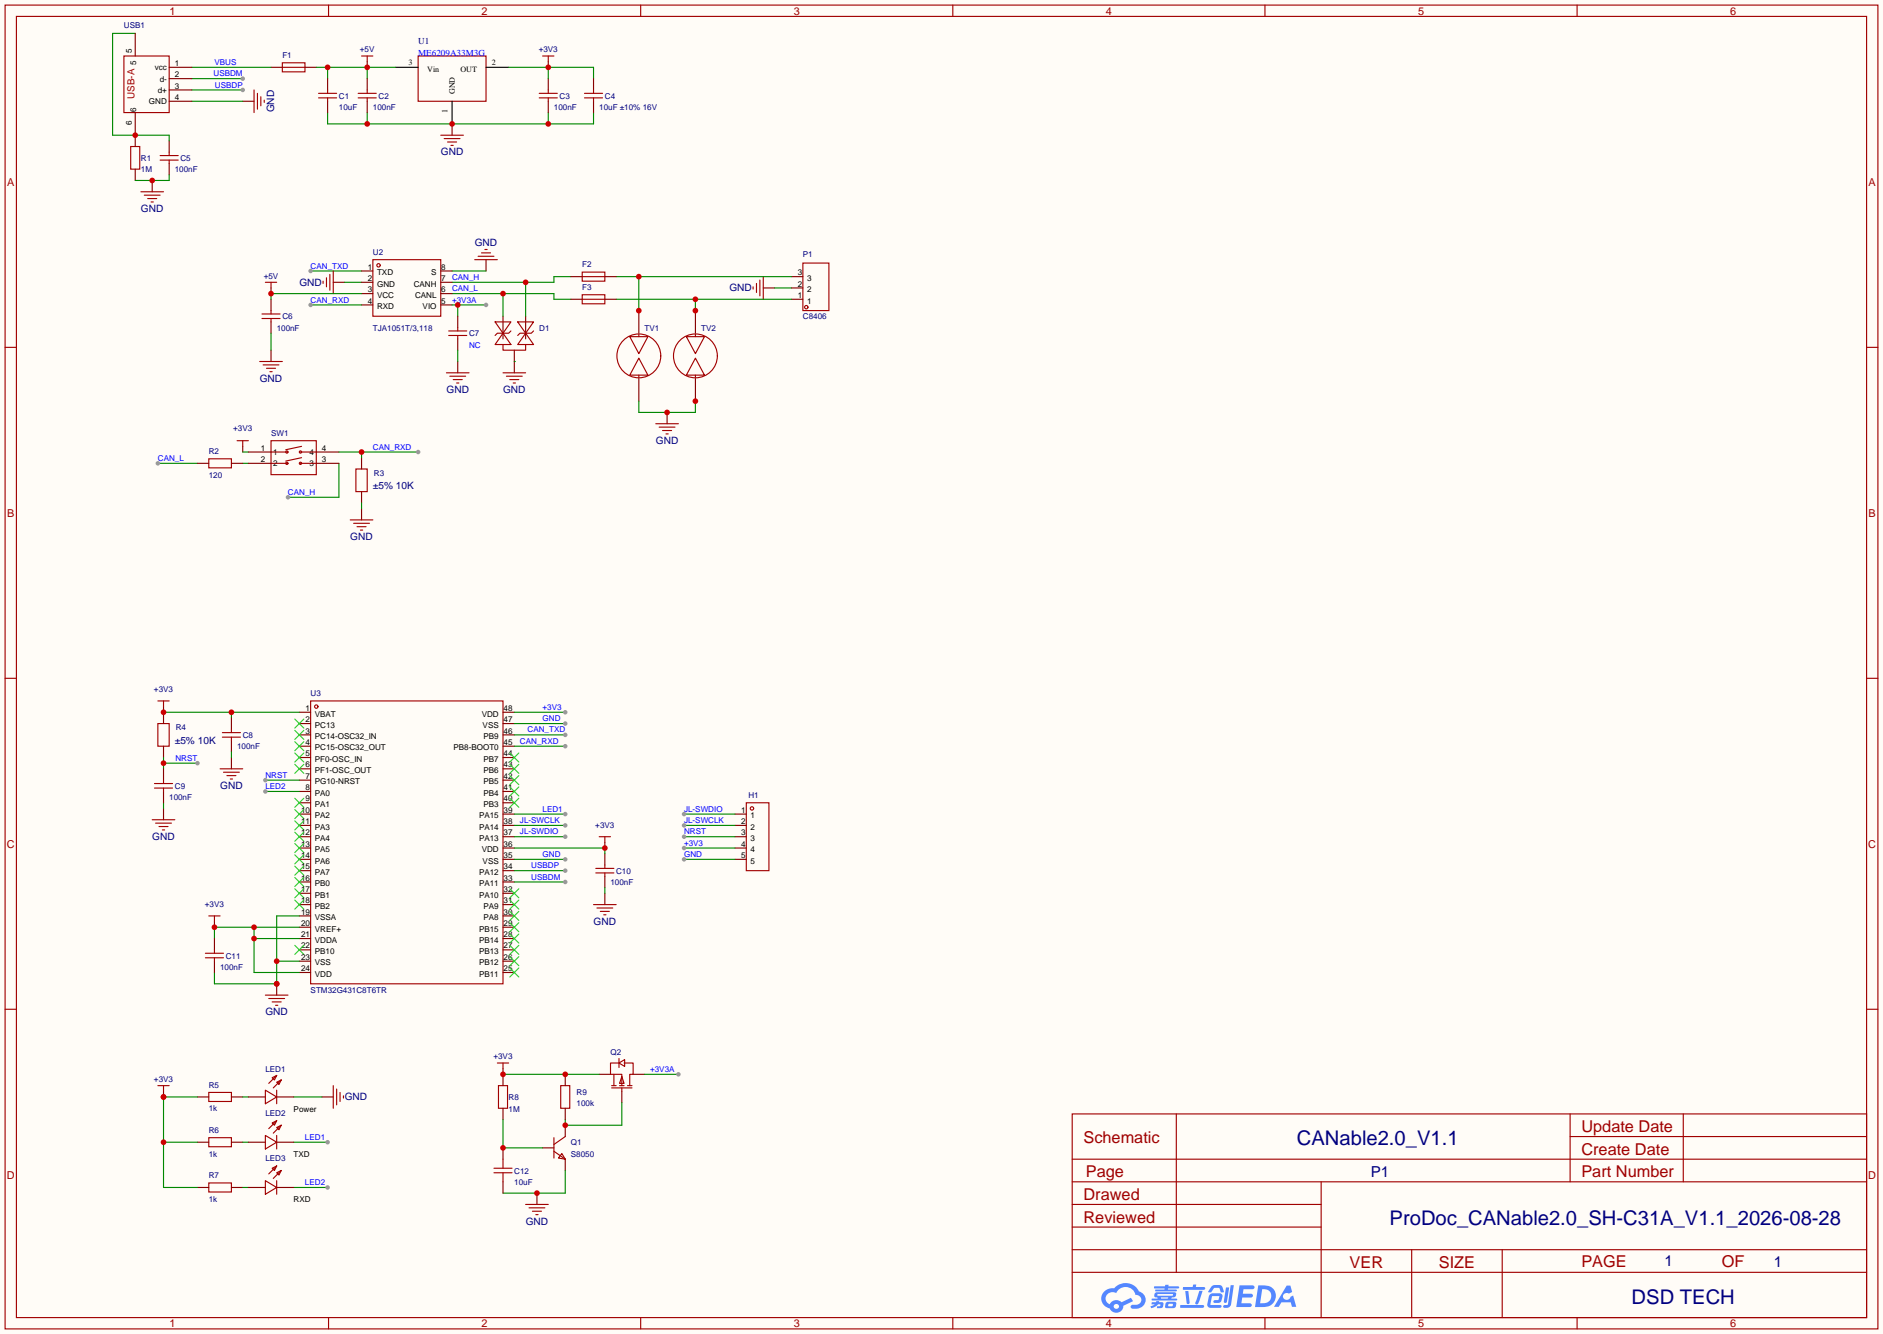
[picture p11: page 1]
