dsdtech-official/can-adapters/(list of files, drawings)

Other design files:
SH-C30A/hardware/SH-C30A-V1.21.PcbDoc
SH-C30A/hardware/SH-C30A-V1.21.SchDoc
SH-C30L/hardware/SH-C30L-V1.0.SchDoc
SH-C31A/hardware/SH-C31A-V1.1.PcbDoc
SH-C31G/hardware/SH-C31G-V1.0.PcbDoc
SH-C31G/hardware/SH-C31G-V1.0.SchDoc
