dsdtech-official/can-adapters/(commit log)

2026-08-27 Initial structure for SH-C30A and SH-C31A
    One folder per model, holding everything a customer needs: manual, datasheet,
    hardware files, firmware notes and runnable examples. Shared documentation that
    applies to every adapter is in docs/.
    Binaries are not committed - firmware images, fabrication bundles and driver
    packages are attached to Releases instead.
2026-08-28 Add SH-C30A board files, upstream attribution and licence notices
    Hardware
    - SH-C30A-V1.21.SchDoc / .PcbDoc, board revision V1.21 (silkscreen V1-20230506).
    Protel ASCII, committed byte-exact.
    - Component metadata translated from Chinese to English.
    - .gitattributes: LF everywhere, except the EDA sources, which are pinned to
    byte-exact. The Protel ASCII PCB format carries lone CR characters as record
    separators, so any end-of-line conversion would corrupt the board file.
    Licensing
    - THIRD-PARTY-NOTICES.md records the whole chain in one place: the candleLight
    hardware lineage (Hubert Denkmair, CERN-OHL-1.2) with a verified list of what
    differs from it, the candleLight_fw firmware pr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
    [SH-C30A-V1.21.PcbDoc, SH-C30A-V1.21.SchDoc]
2026-08-28 Drop an unsourced open-hardware claim from the model pages
    Both model READMEs said the boards were "derived from the CANable
    open-hardware design". The CANable project never published any hardware
    design files -- its author's repositories contain firmware only -- so
    "open-hardware design" has no source behind it.
    Say what is verifiable instead: these are part of the CANable family. The
    SH-C30A page points at THIRD-PARTY-NOTICES.md, where the lineage that can
    be evidenced (candleLight, CERN-OHL-1.2) is set out in full.
2026-08-28 SH-C30A: replace the slcan example with a gs_usb one
    The slcan example told customers to use a firmware we do not ship. The
    SH-C30A leaves the factory running candlelight, and the images we publish
    are candlelight builds, so nothing in the box gets you to a serial port.
    python-gsusb.py talks to the adapter as it ships. The call shape comes from
    a probe that has been run against real SH-C30A hardware. Its header says
    plainly that Linux users want SocketCAN instead -- the kernel claims the
    adapter there -- and it covers the libusb runtime that Windows does not
    provide, including the missing ARM64 wheel.
    [python-gsusb.py, python-slcan.py]
2026-08-28 Add the JLC EDA project file for the SH-C30A
    This is the format the board is actually edited in. The Protel ASCII files
    next to it are exports of it, and lossy ones -- degree signs disappear on the
    way out -- so the project is the one to take if you intend to change the board
    rather than read it.
    CERN OHL v1.2 section 3.4(d) asks for the preferred format for making
    modifications, which is this, and for a format readable with an OSI-licensed
    tool when that one is proprietary, which is the schematic PDF still to come.
    Generated by tools/make-release-hw.py: 1349 Chinese strings translated,
    11482 JSON objects in and 11482 out, project2.json byte for byte.
    .gitattributes now names .epro2 and .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
2026-08-28 Add the SH-C30A schematic PDF
    This is the copy for people who do not run an EDA tool, and it is what CERN
    OHL v1.2 section 3.4(d) asks for alongside the project file: a format readable
    with an OSI-licensed tool when the native one is proprietary.
    The title block travels with it, so the sheet still says which board and which
    revision it is once it has been downloaded, forwarded or printed away from
    this repository.
    Also makes the .epro2 build reproducible. The archive was being rebuilt with
    current timestamps on every run, so re-running the transform produced a
    different 160 KB blob each time for content that had not changed. Entry
    metadata now comes from the source archive.
2026-08-28 SH-C30A: drop the CANable 2.5 note, and point at the Amazon listing
    CANable 2.5 does not belong on this page. It is built for the G431 and G473,
    which is the SH-C31A's silicon, not the STM32F072 in this board -- upstream
    ships no F0 build target at all. Leaving it here invited an owner of this
    adapter to go looking for a firmware that cannot run on it.
    The buy link now goes to the Amazon listing, which is where these actually
    sell, and says the adapter is also stocked on Amazon UK, Europe, Japan and
    Australia. The deshide.com product page stays as the second link, since that
    is where the support documents live.
2026-08-28 SH-C30A: tell owners of older stock what they have and how to move
    Production ships our own candlelight build, v2.1, but adapters reach people
    through distribution, so a unit bought this week can still be older stock on
    an earlier firmware. The page now says so, says those units are not faulty,
    and gives a check that takes ten seconds: v2.1 reports itself over USB as
    SH-C30x by DSD TECH, and anything else is an earlier build. That test only
    asserts what our own image does, so it stays correct however many earlier
    builds are out there.
    It also records that v2.1 runs the microcontroller from the 24 MHz crystal
    fitted on the board. No claim is made about what that buys you -- we have not
    measu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
2026-08-28 SH-C31A: it does CAN FD out of the box, so say so
    The pages held back from the last release said this adapter ships without
    CAN FD and that reflashing to slcan is what turns it on. That is wrong for
    the firmware it actually ships with. v1.4 is a gs_usb build of the CAN FD
    fork of candleLight, and FD runs over the same interface as classic CAN --
    no second firmware, no serial port.
    Every figure on the firmware page is a measurement on this board rather than
    a datasheet number: five FD data rates from 1 M to 5 M carrying 64-byte
    payloads intact, five nominal rates at zero loss, and a 180-second soak at
    2 Mbit/s that moved 17548 frames without losing one.
    Two traps are documented because both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
2026-08-28 SH-C31A: add the schematic PDF
    The export passes on its own terms this time: no Chinese, and the title block
    carries SH-C31A, V1.1 and DSD TECH, so the sheet still says which board it is
    once it has been downloaded or printed away from here. That completes what
    CERN OHL v1.2 section 3.4(d) asks for -- the project file for changing the
    board, and a readable format for everyone else.
    The transform no longer needs the PDF to arrive under a fixed name. The EDA
    names its own export and stamps the date into it, so the name changes every
    time; the script now takes the only PDF in the source folder and says which
    one it took, and refuses to guess when there is more than one.
2026-08-28 Put the firmware downloads on the firmware page
    Both firmware pages said the images were "attached to Releases" and left the
    reader to go and find them. With two boards in one repository the Releases
    page is a list of tags, and the tag names carry slashes, so finding the right
    one is more work than it should be.
    Each page now links its own release and every file in it directly, says which
    file to start with, and shows the one command that checks what was downloaded.
    The references further up the page point at that section rather than at the
    Releases list.
    The direct URLs were taken from the API and each one verified to return 200 --
    the tags contain a slash, and it was worth confirming Git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
2026-08-28 Document what the three LEDs mean
    No document in the repository has ever said what the lights do, and two of
    their behaviours read as faults:
    - the two green LEDs stay dark until software opens the CAN channel, so a
    healthy idle adapter shows one red light and nothing else;
    - once the channel is open they sit lit and wink *off* per frame, so an
    open idle adapter looks stuck on.
    Both come straight from the firmware: can_common.c puts the LEDs in
    LED_MODE_OFF while the channel is closed and LED_MODE_NORMAL while it is
    open, and led.c drives them lit-with-a-30-ms-wink in that mode. The wake-up
    flicker at plug-in and the 100 ms alternation under an identify request are
    from the sam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
2026-08-28 Add an issue form and a security policy
    Opening an issue was completely bare: no template, no contact links, and
    nothing telling a reporter what we need in order to answer. The form asks
    for the four things every report needs anyway -- model, firmware, host OS
    and bit rate -- and puts termination, the LEDs and firmware identification
    in front of the reporter first, because those three answer most reports.
    Written against the repository as it stands, not from the 2026-08-12 draft
    that assumed separate hardware and firmware repositories: that draft pointed
    at repositories that were never created, named a firmware we do not ship,
    and got our own licence wrong.
    SECURITY.md keeps one paragraph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
2026-08-28 Link both boards' hardware folders from the LED page
    The sentence said "on both boards" and linked only one of them.
2026-09-01 Say when a board actually ships with the current firmware
    Both firmware pages said the current build is "what the boards ship with",
    present tense. Production starts fitting it in September 2026, so today that
    sentence is wrong in the one direction that matters: someone who buys now gets
    an earlier build while the page tells them otherwise.
    Both pages now name the month, and both say plainly that earlier units are not
    faulty. That last part is not padding -- an upgrade notice reads as a defect
    notice unless you say it does not.
2026-09-02 Take the internal part numbers off the two isolated schematics
2026-09-17 SH-C31B: firmware page, and note that the silkscreen reads SH-C31A
2026-09-17 Note the enclosure colours of the SH-C31A and SH-C31B
2026-09-17 FD sample points: the arbitration phase must match, not the data phase
2026-09-17 FD sample points: non-BRS frames lose about a third, not none
2026-10-26 Clarify SH-C31A firmware versions and frame loss limits
